FedericoBusero/ESP32-CAM_ZeppelinCAM/(commit log)

2022-04-03 print/println functions memory usage
2022-04-04 faster motor resume after pause (no reception)
2022-04-18 camrea 20->8MHz : wifi performance
    espressif/arduino-esp32#5834
2022-04-27 halt L/R motor when connection lost
2022-04-28 Motor+servo Easer (#6)
    Easer functionality
2022-04-28 delayed camera_init
    for in case of low power use of zeppelin without camera
2022-04-28 remove hg... motor rename drv to hbridge...
2022-05-29 ESP32 Arduino core version
2022-05-29 Federico busero videoswitch (#7)
    * Update ESP32-ZeppelinCAM.ino
    * Update zeppelincam_html.h
2022-05-29 multiple client detection (#8)
    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
2022-05-29 move hbridge_halt & hbridge_run above updateMotors (compiling issues)
    [ESP32-ZeppelinCAM.ino]
2022-09-18 ESP32 core version
2023-04-22 Delay no longer necessary
    was necessary in the past because of easing
    [ESP32-ZeppelinCAM.ino]
2023-04-22 wait some time after camera initialisation before taking pics
2023-04-22 channel reallocation
    for compatibility with ESP32-C3 without camera (uncomment USE_CAMERA)
2023-04-22 XIAO ESP32S3 Sense support!
2023-04-22 support for lolin C3 pico (without cam)
2023-04-22 Pin definitions XIAO ESP32S3 Sense
2023-04-23 Faster SERVO_SWEEP_TIME & MOTOR_TIME_UP
2023-04-23 old esp32 arduino board version
2023-06-13 Pin allocation XIAO S3 :Make picture & text in readme & code consistent (#9)
2023-06-14 Arduino - OPI PSRAM
